iwantmymalatang/ASTRA-/README.md

  ASTRA 

[Read the illustrated replication guide](ASTRA%20Documentation%20%28Aug%202026%29.md) — a scrollable build guide with full-resolution images.

Our vision is for radio astronomy to be a globally accessible platform. We provide designs to cheap (under 300 USD), reproducible designs to radio telescopes that can be replicated anywhere. We aim to create a scalable platform where everyone can document, collaborate, synchronise and create an interferometer with the region around them, creating opportunities for hands-on STEM education, technological development and international cooperation 

Here you will find stl files for 3d designs as well as modifications to other designs

For rotator, please visit [SatNOGS](https://gitlab.com/librespacefoundation/satnogs/satnogs-rotator/blob/master/rotator-bom.ods) for their rotator design as that was what was used

Visit our website at [ASTRA WORLD](https://astra-world.net/)
