iwantmymalatang/ASTRA-/Modified Rotator Designs (SatNOGs V3) STEP/P3 (Motor Mount) -.step

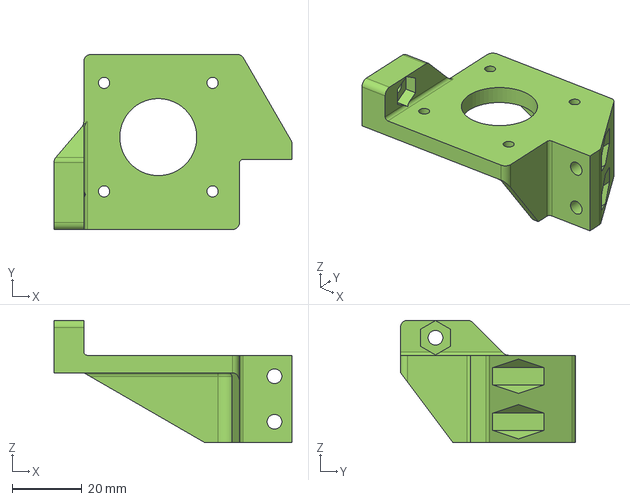
[picture p33: CAD file, 2026-10-23]
Modified Rotator Designs (SatNOGs V3) STEP/P3 (Motor Mount) -.step
68.0 x 50.0 x 35.0 mm
