iwantmymalatang/ASTRA-/P8 (Gear).step

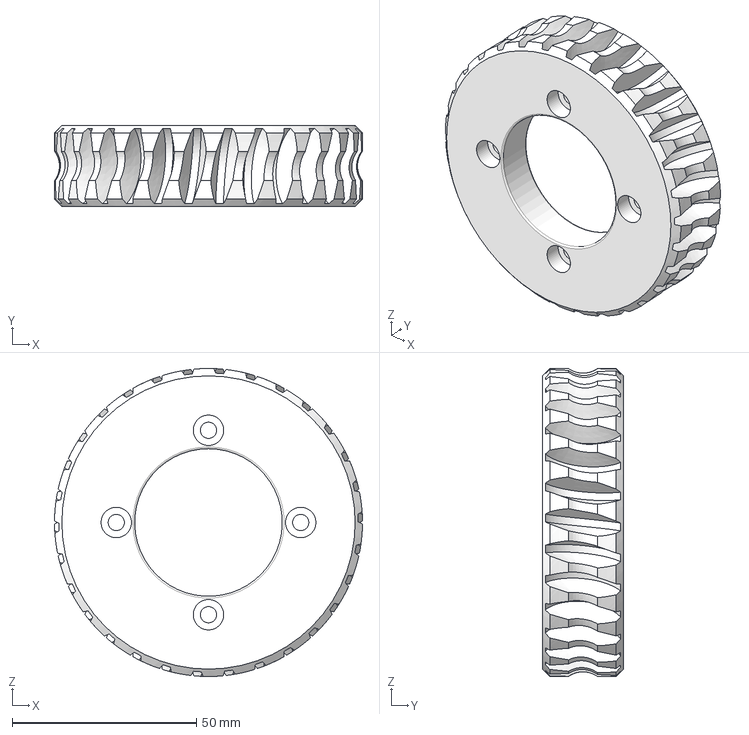
[picture p34: CAD file, 2026-10-23]
P8 (Gear).step
83.5 x 22.0 x 83.5 mm
