iwantmymalatang/ASTRA-/STL Files for Parabolic Dish/Dish and rotator connector.stl

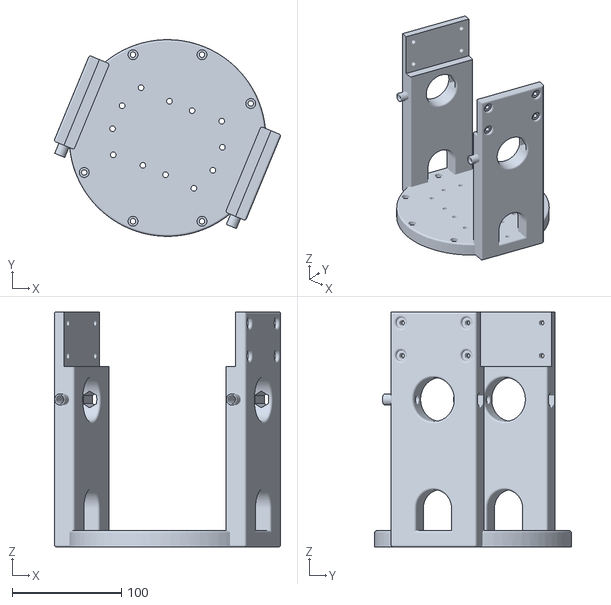
[picture p35: CAD file, 2026-10-14]
STL Files for Parabolic Dish/Dish and rotator connector.stl
206.8 x 179.9 x 215.0
