iwantmymalatang/ASTRA-/Modified Rotator Designs (SatNOGs V3) STEP/P7 (Collar) -.step

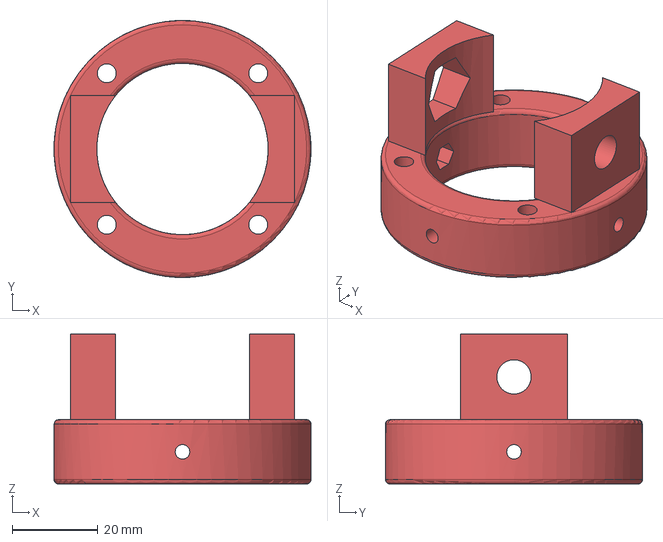
[picture p36: CAD file, 2026-10-23]
Modified Rotator Designs (SatNOGs V3) STEP/P7 (Collar) -.step
60.0 x 60.0 x 35.0 mm
