iwantmymalatang/ASTRA-/P2 (Worm Gear Support B) -.step

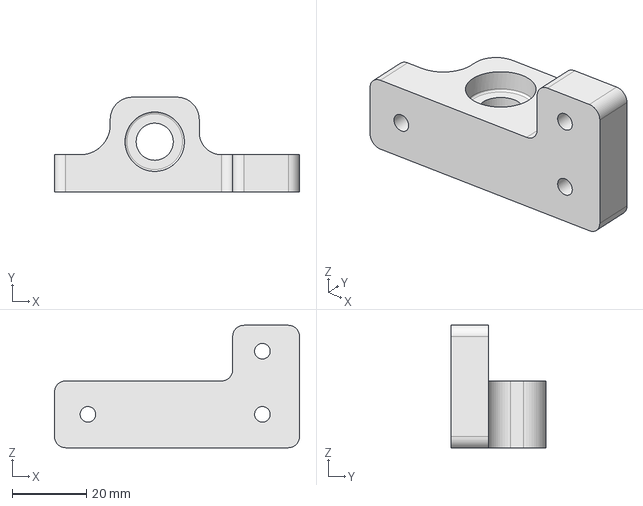
[picture p37: CAD file, 2026-10-23]
P2 (Worm Gear Support B) -.step
66.0 x 25.5 x 33.0 mm
