iwantmymalatang/ASTRA-/STL Files for Base Design/Tripod top.stl

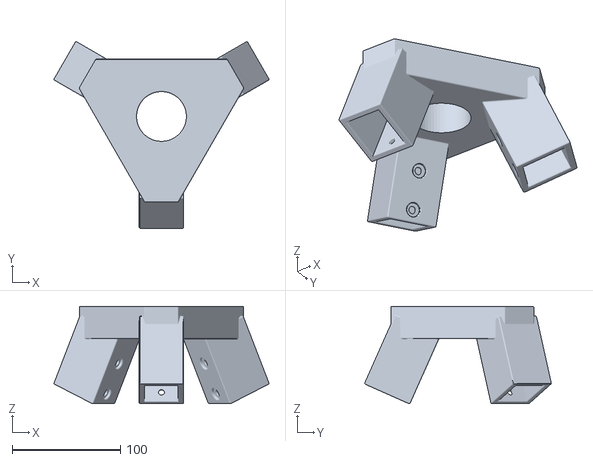
[picture p38: CAD file, 2026-10-14]
STL Files for Base Design/Tripod top.stl
198.7 x 172.5 x 90.1
