iwantmymalatang/ASTRA-/STL Files for Parabolic Dish/Counterweight hook.stl

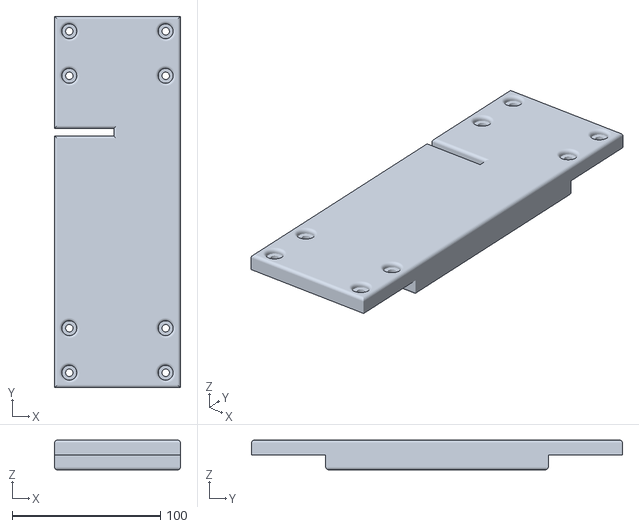
[picture p39: CAD file, 2026-10-14]
STL Files for Parabolic Dish/Counterweight hook.stl
84.9 x 250.0 x 20.0
