iwantmymalatang/ASTRA-/Modified Rotator Designs (SatNOGs V3) STEP/P4 (Shaft).step

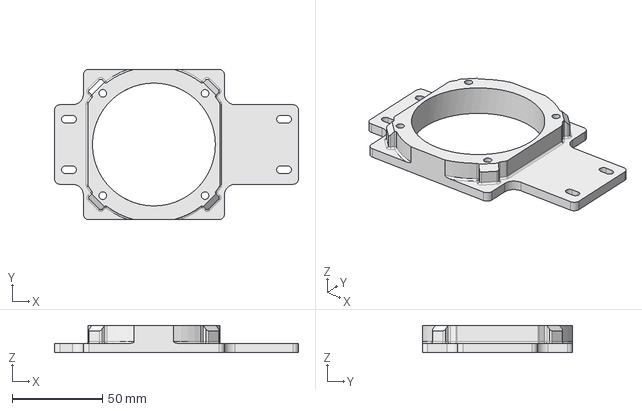
[picture p40: CAD file, 2026-10-23]
Modified Rotator Designs (SatNOGs V3) STEP/P4 (Shaft).step
135.0 x 83.2 x 15.0 mm
