iwantmymalatang/ASTRA-/P1 (Worm Gear Support A) -.step

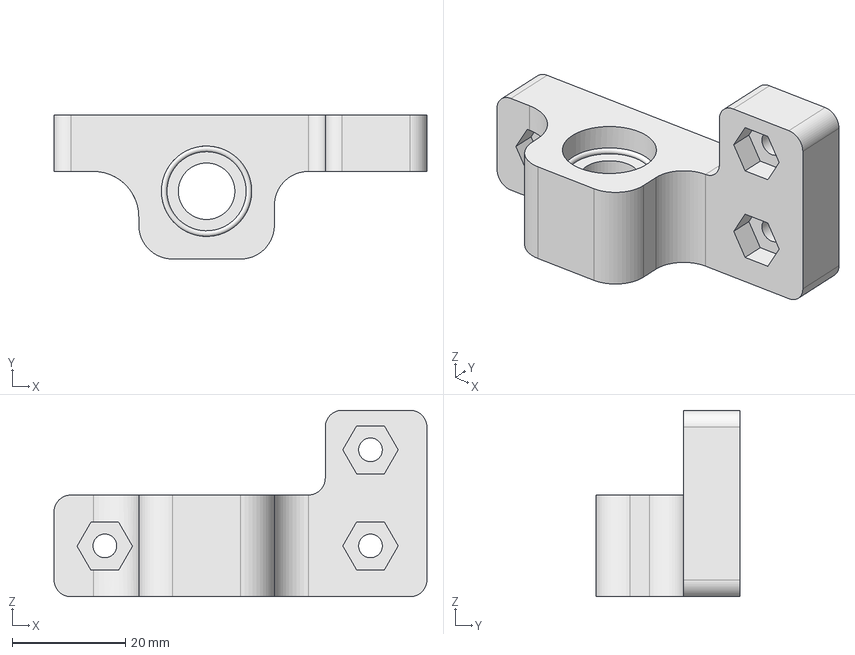
[picture p41: CAD file, 2026-10-23]
P1 (Worm Gear Support A) -.step
66.0 x 25.5 x 33.0 mm
