iwantmymalatang/ASTRA-/STL Files for Base Design/Tripod side.stl

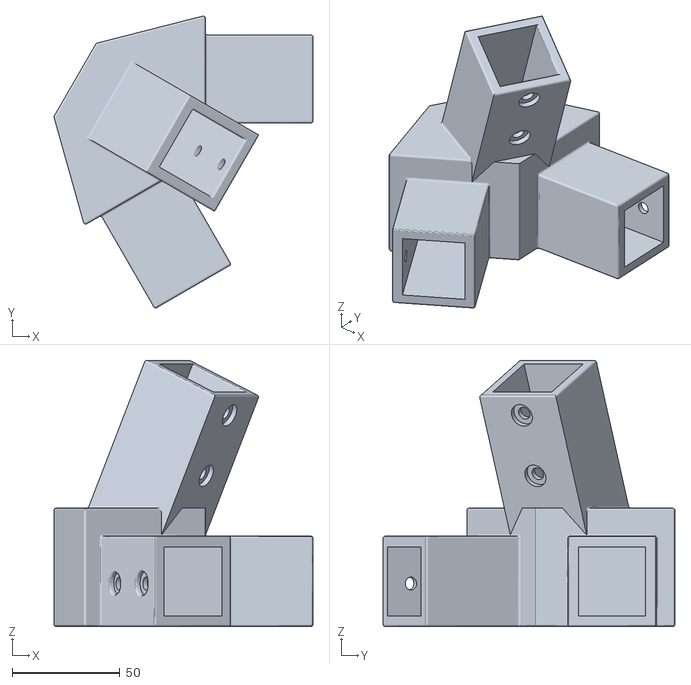
[picture p42: CAD file, 2026-10-14]
STL Files for Base Design/Tripod side.stl
120.4 x 135.6 x 123.7
