iwantmymalatang/ASTRA-/STL Files for Parabolic Dish/Fixture.stl

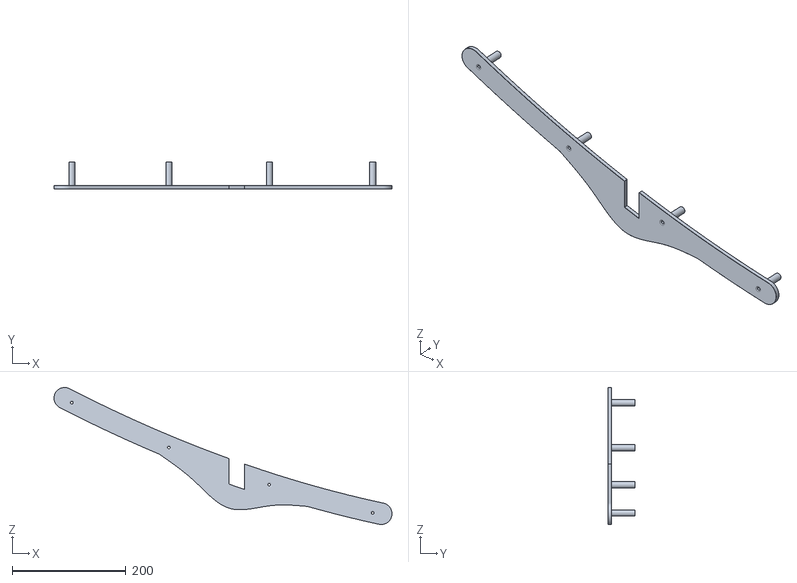
[picture p43: CAD file, 2026-10-14]
STL Files for Parabolic Dish/Fixture.stl
595.4 x 48.3 x 241.4
