iwantmymalatang/ASTRA-/Modified Rotator Designs (SatNOGs V3) STEP/P5 (Cover).step

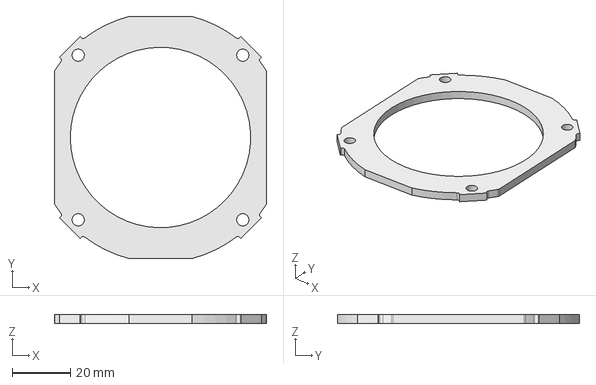
[picture p44: CAD file, 2026-10-23]
Modified Rotator Designs (SatNOGs V3) STEP/P5 (Cover).step
73.0 x 83.2 x 3.00 mm
