iwantmymalatang/ASTRA-/P6 (Endstop Mount).step

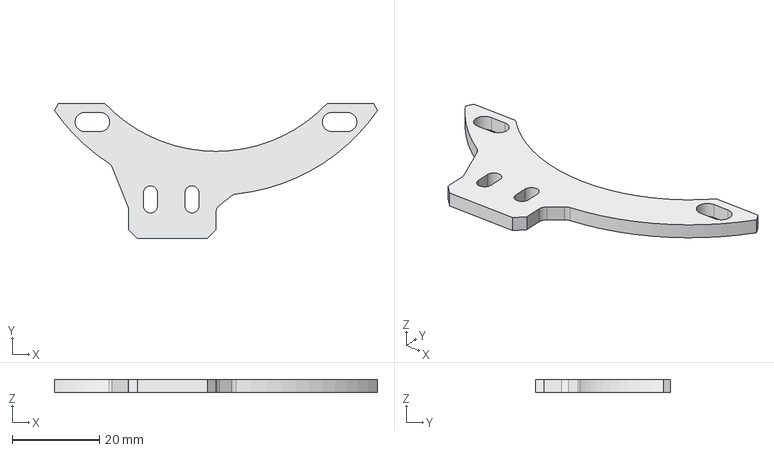
[picture p45: CAD file, 2026-10-23]
P6 (Endstop Mount).step
73.9 x 31.0 x 3.00 mm
