iwantmymalatang/ASTRA-/STL Files for Base Design/Stabaliser.stl

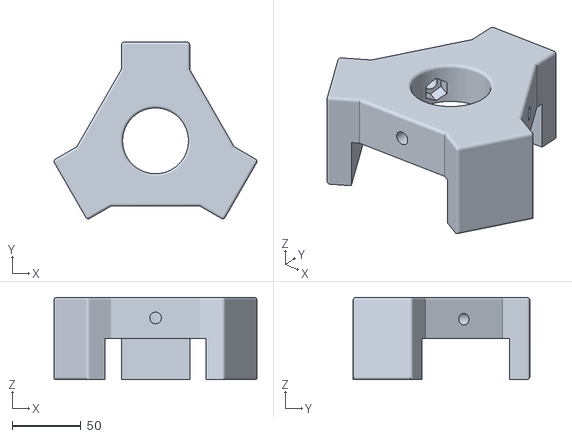
[picture p46: CAD file, 2026-10-14]
STL Files for Base Design/Stabaliser.stl
148.1 x 128.9 x 60.0
