iwantmymalatang/ASTRA-/Modified Rotator Designs (SatNOGs V3) STEP/P9 (Worm Gear).step

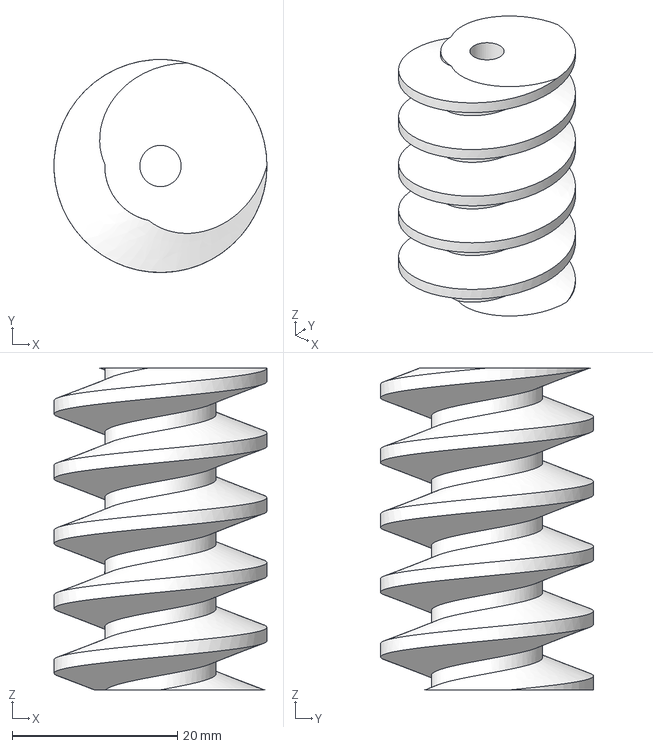
[picture p47: CAD file, 2026-10-23]
Modified Rotator Designs (SatNOGs V3) STEP/P9 (Worm Gear).step
25.8 x 25.8 x 39.0 mm
