iwantmymalatang/ASTRA-/Rotator support (will redesign).stl

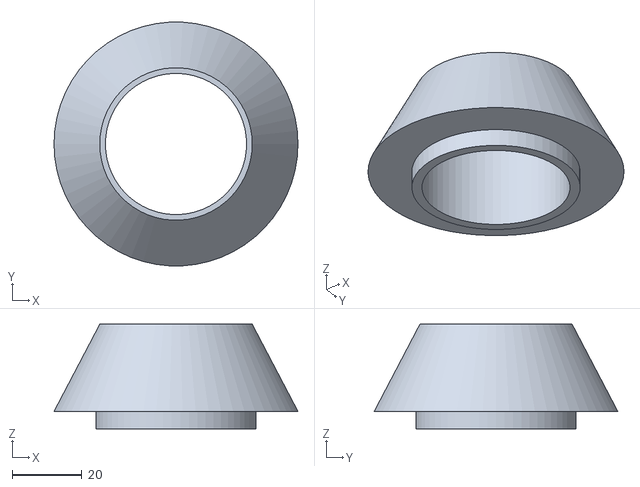
[picture p48: CAD file, 2026-10-14]
Rotator support (will redesign).stl
70.0 x 69.9 x 30.0
