iwantmymalatang/ASTRA-/Electronics box for NodeMCU, Breadboard, SBASE v1.3.stl

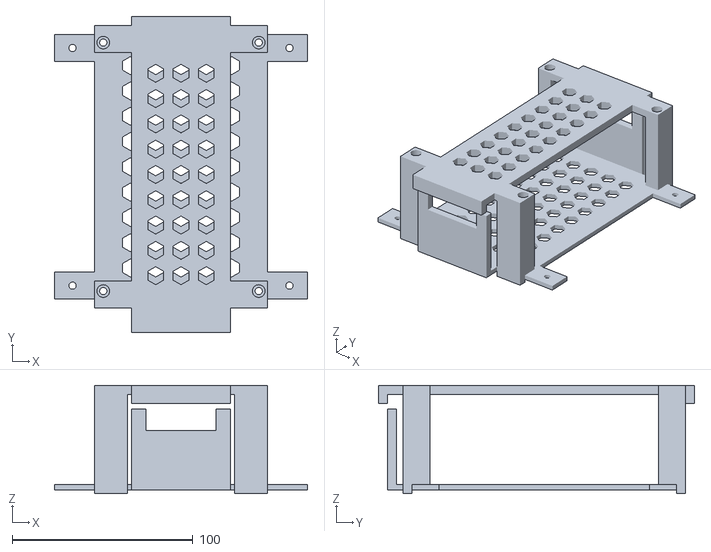
[picture p49: CAD file, 2026-10-14]
Electronics box for NodeMCU, Breadboard, SBASE v1.3.stl
140.0 x 175.0 x 60.0
