iwantmymalatang/ASTRA-/STL Files for Base Design/Modified SatNOGS part, use m8 screws.stl

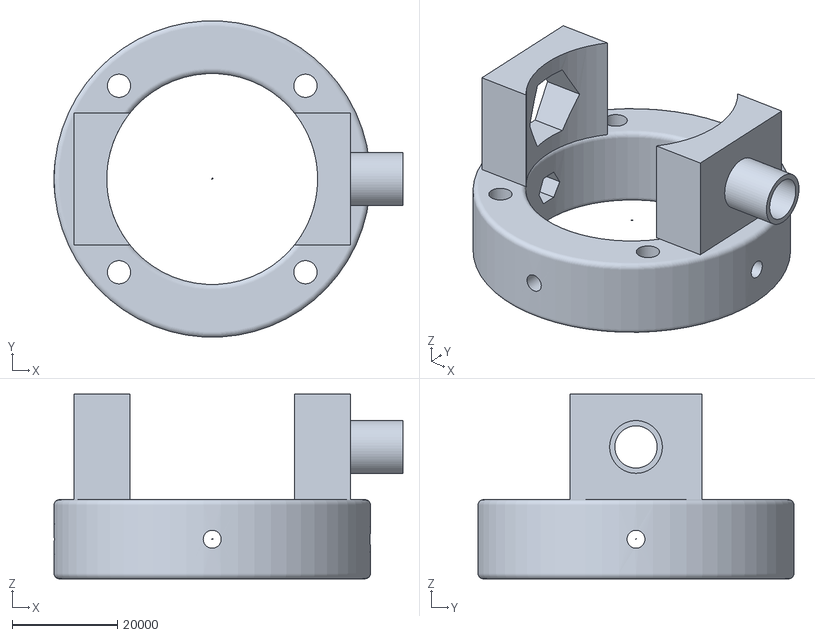
[picture p50: CAD file, 2026-10-14]
STL Files for Base Design/Modified SatNOGS part, use m8 screws.stl
66178.4 x 59999.7 x 35000.0
