iwantmymalatang/ASTRA-/(commit log)

2026-10-14 Rename Stabaliser.stl to STL Files for Base Design/Stabaliser.stl
2026-10-14 Rename Electronics box for NodeMCU, Breadboard, SBASE v1.3.stl to STL Files for Electronics/Electronics box for NodeMCU, Breadboard, SBASE v1.3.stl
2026-10-14 Add files via upload
    Add between Rotator and Tripod stand, not mechanically viable, meant to support bearing
2026-10-14 Rename Rotator support (will redesign).stl to STL Files for Parabolic Dish/Rotator support (will redesign).stl
2026-10-14 Rename Fixture.stl to Quick Assembly Fixture.stl
2026-10-23 Rename P1 (Worm Gear Support A) -.step to Modified Rotator Designs (SatNOGs V3) STEP/P1 (Worm Gear Support A) -.step
2026-10-23 Modify Worm Gear Support B design in STEP file
